jnedbal/stirrer_2_1/renders/stir06B_coils.png

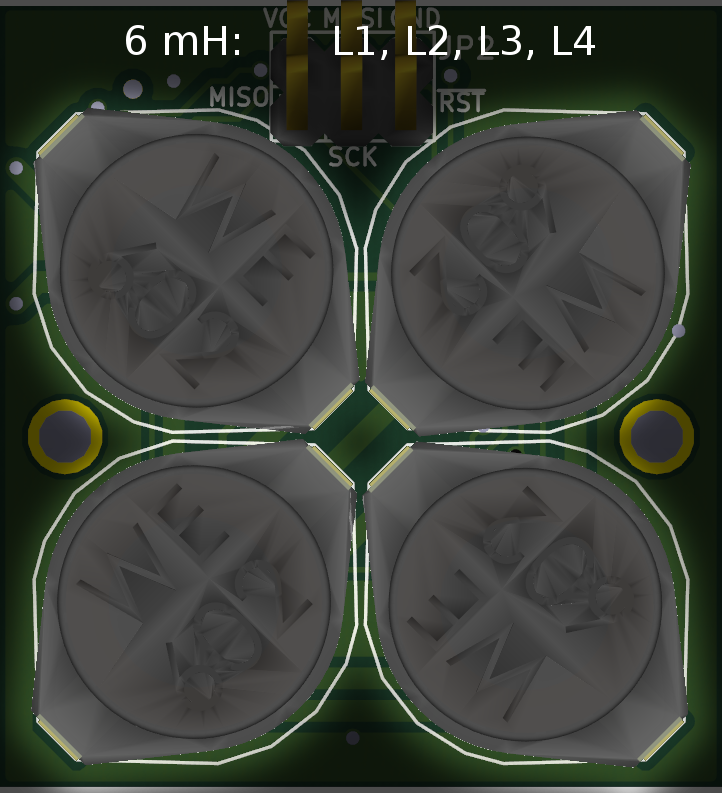
renders/stir06B_coils.png
