jnedbal/stirrer_2_1/renders/stir04F_analog.png

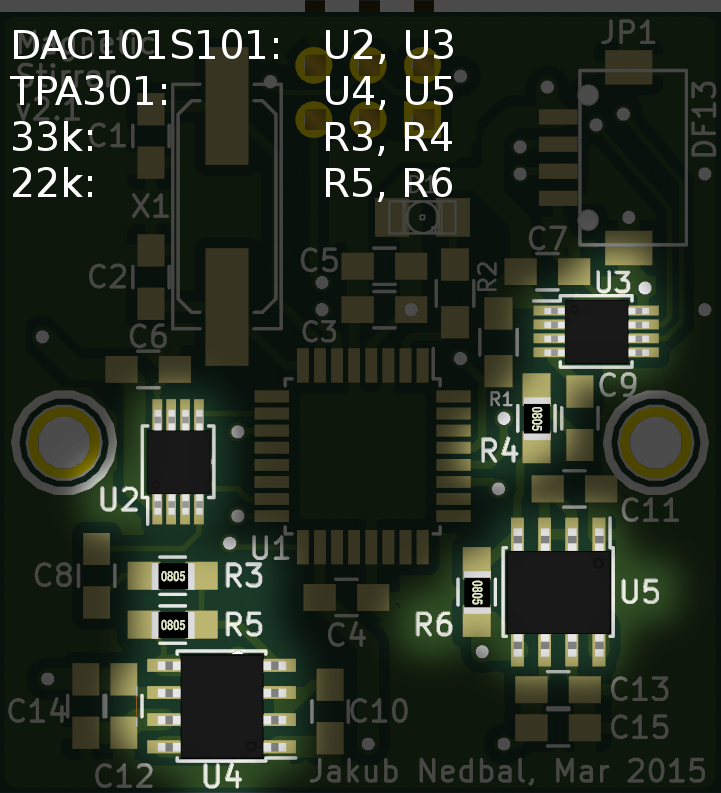
renders/stir04F_analog.png
