jnedbal/stirrer_2_1/connectors.png

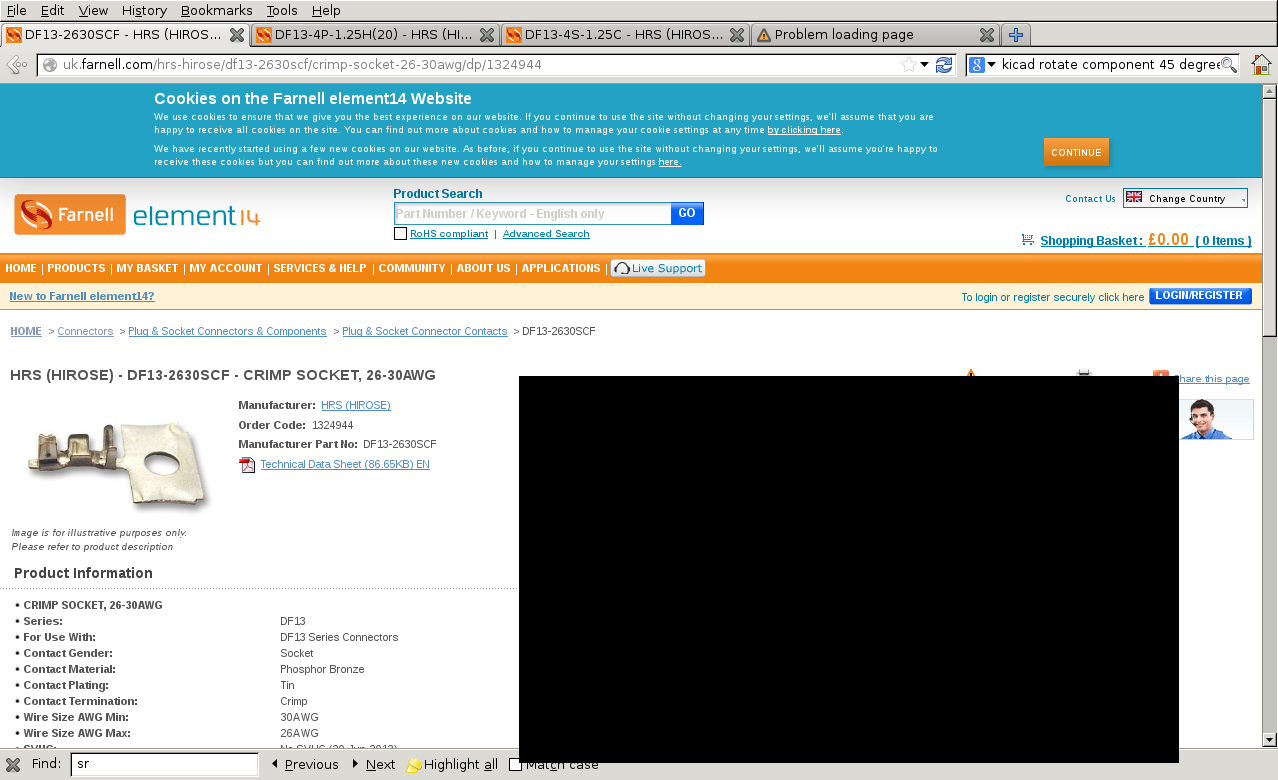
connectors.png
