jnedbal/stirrer_2_1/renders/3D/Animation.gif

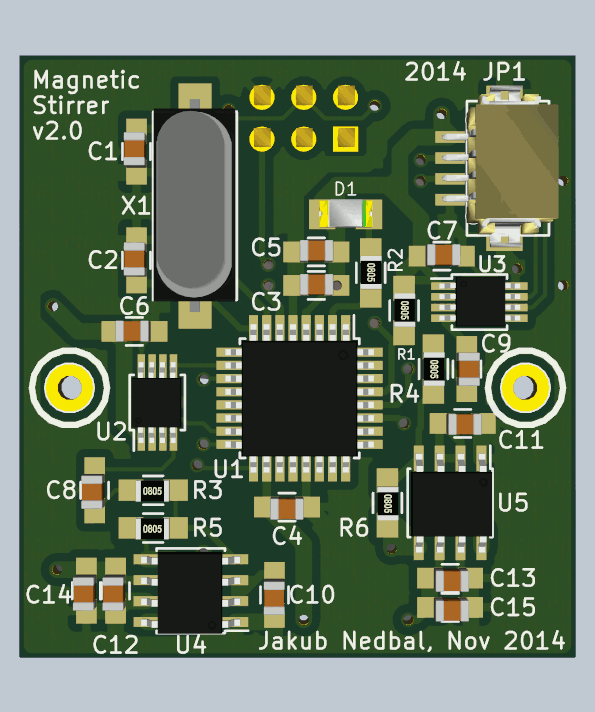
renders/3D/Animation.gif
