jnedbal/stirrer_2_1/renders/allB.png

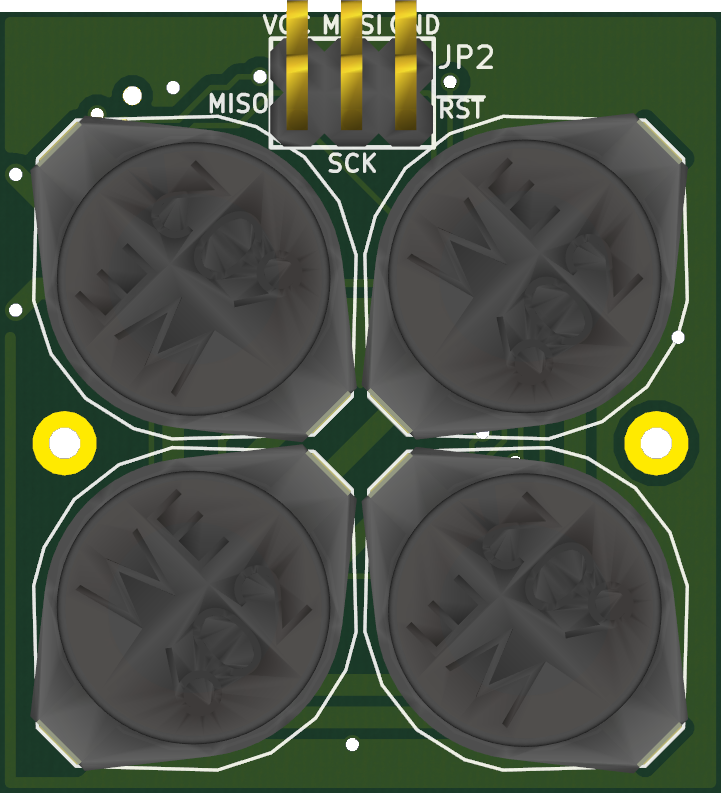
renders/allB.png
