jnedbal/stirrer_2_1/renders/allBempty.png

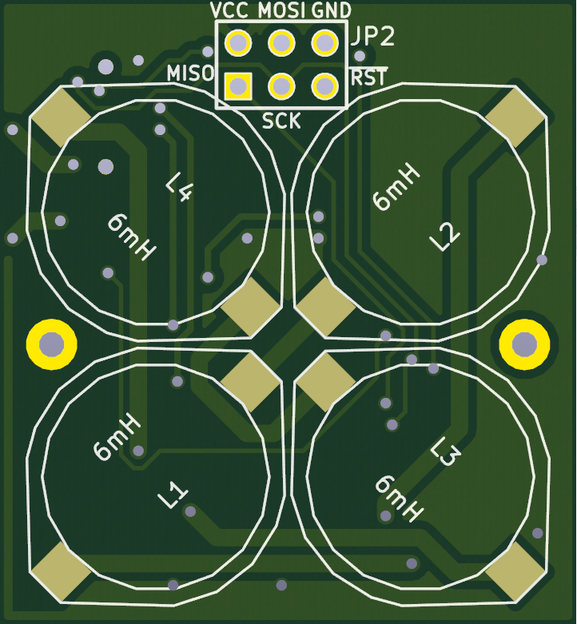
renders/allBempty.png
