jnedbal/stirrer_2_1/renders/allBparts.png

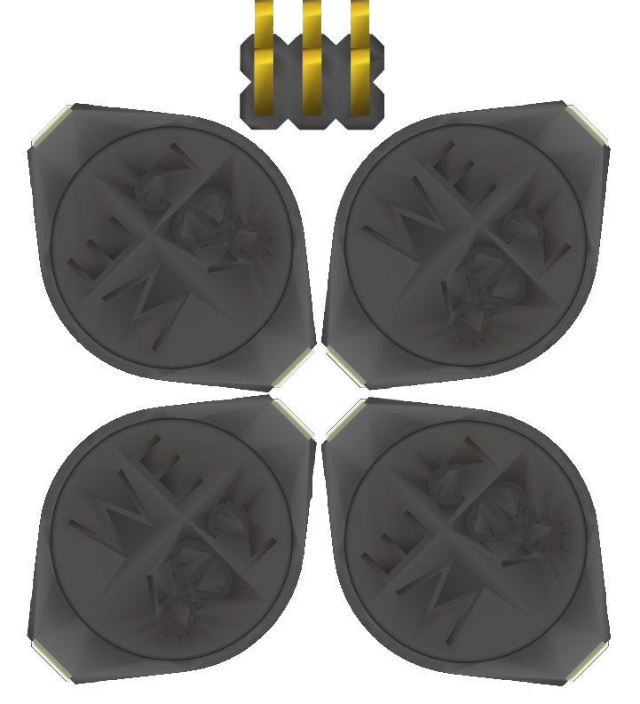
renders/allBparts.png
