jnedbal/stirrer_2_1/renders/allF.png

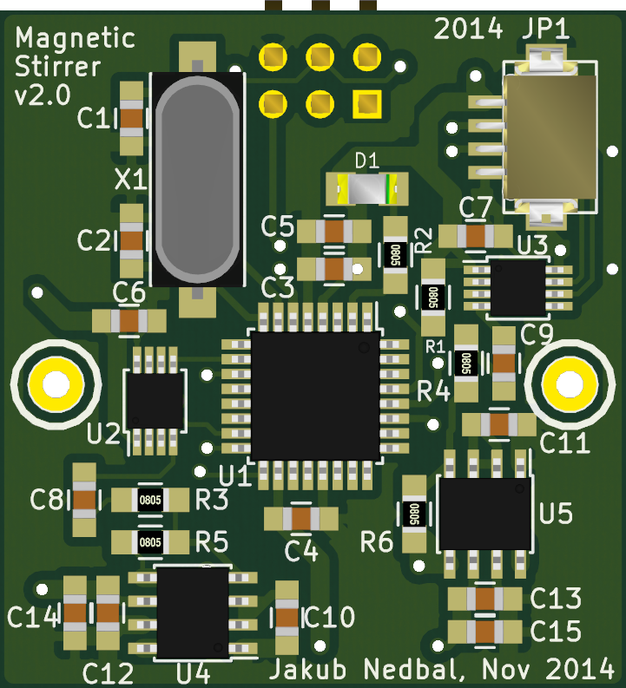
renders/allF.png
