jnedbal/stirrer_2_1/renders/allFempty.png

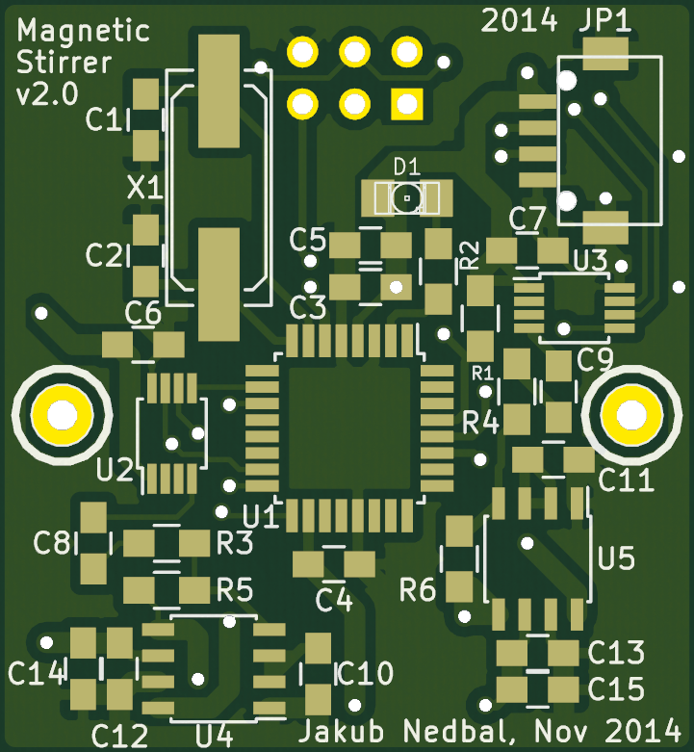
renders/allFempty.png
