jnedbal/stirrer_2_1/renders/allFparts.png

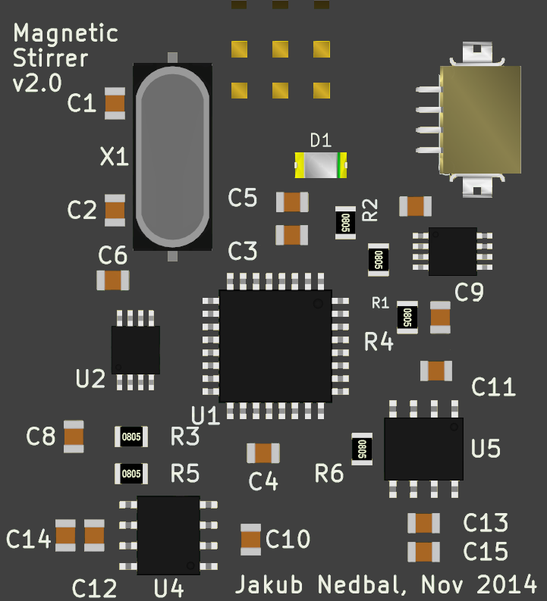
renders/allFparts.png
