jnedbal/stirrer_2_1/renders/stir00B_board.png

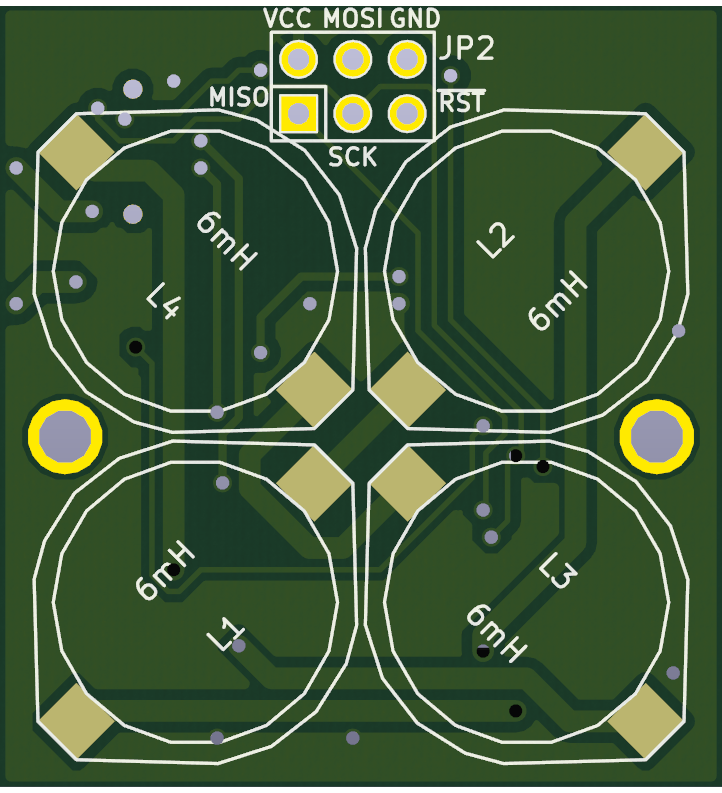
renders/stir00B_board.png
