jnedbal/stirrer_2_1/renders/stir01F_caps.png

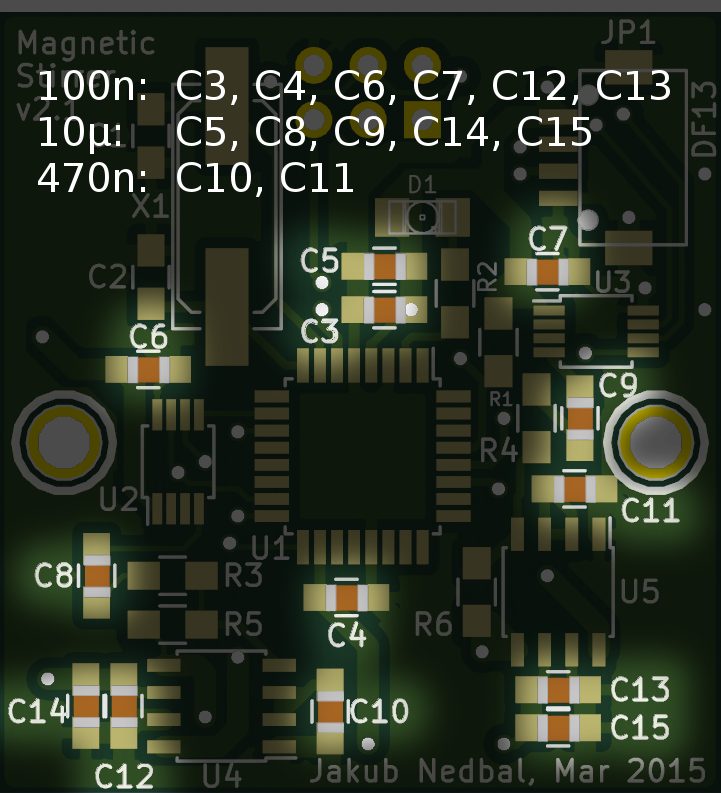
renders/stir01F_caps.png
