jnedbal/stirrer_2_1/renders/stir02F_cpu.png

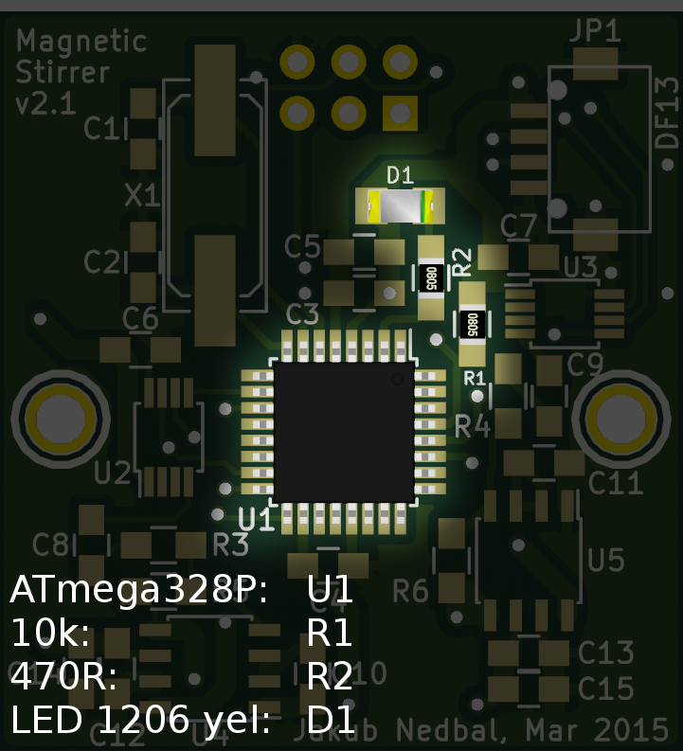
renders/stir02F_cpu.png
