jnedbal/stirrer_2_1/renders/stir03B_conn.png

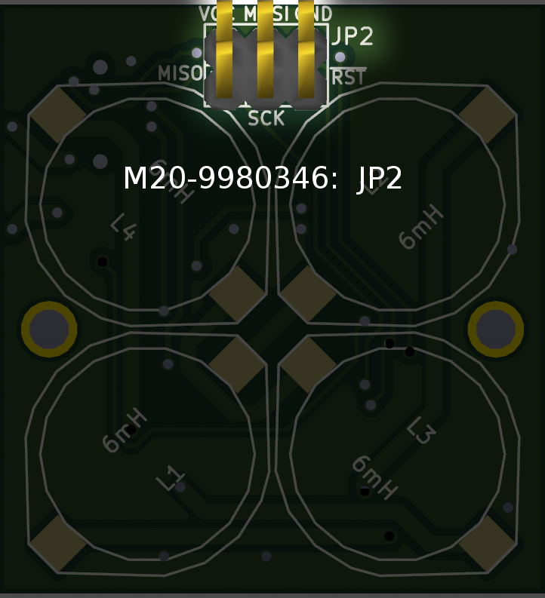
renders/stir03B_conn.png
