jnedbal/stirrer_2_1/renders/stir05F_conn.png

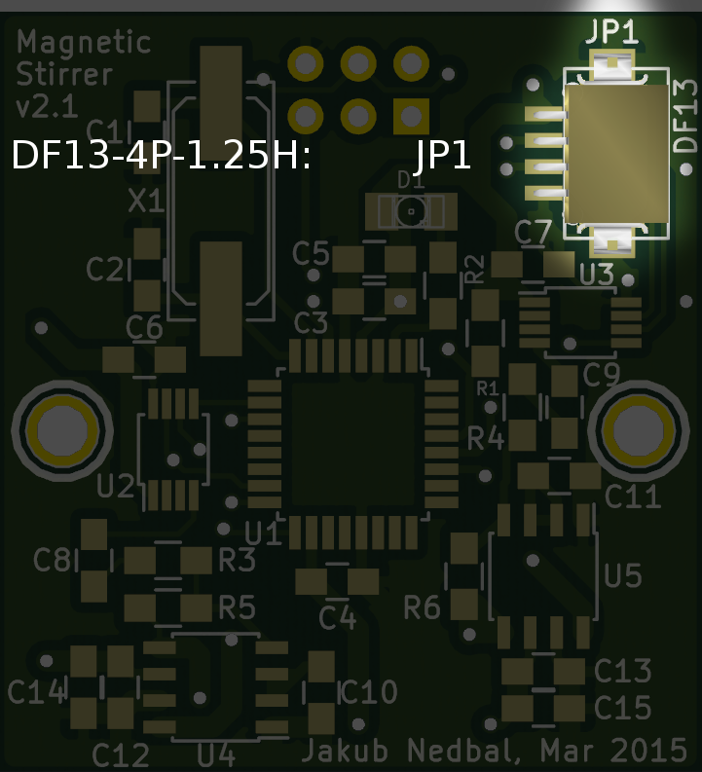
renders/stir05F_conn.png
