jnedbal/stirrer_2_1/renders/stir07F_xtal.png

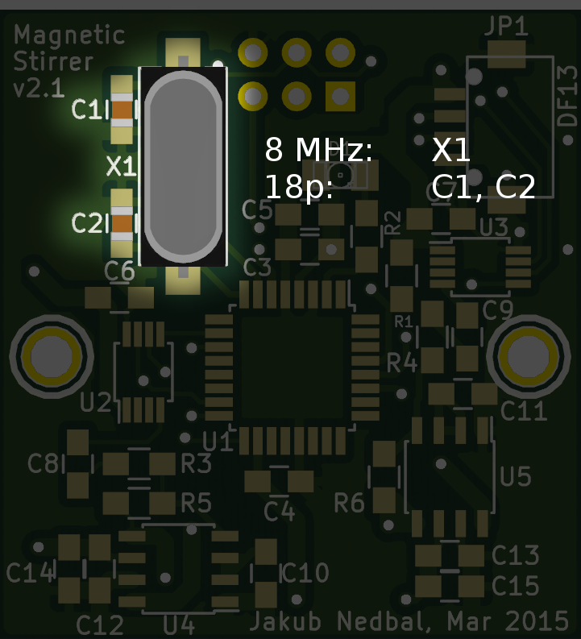
renders/stir07F_xtal.png
