jnedbal/stirrer_2_1/renders/stir08B_parts.png

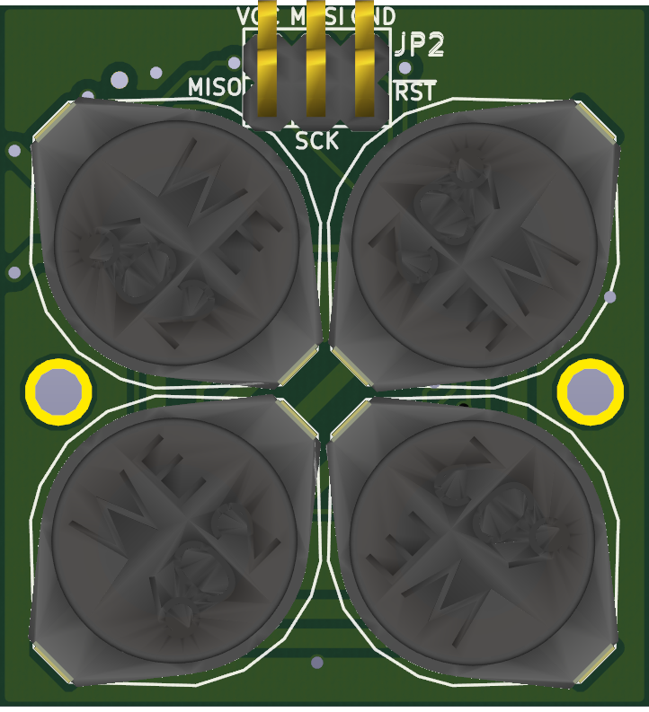
renders/stir08B_parts.png
