jnedbal/stirrer_2_1/stirrer_2_1.kicad_pcb

## KiCad design stirrer_2_1.kicad_pcb (2015-03-08)

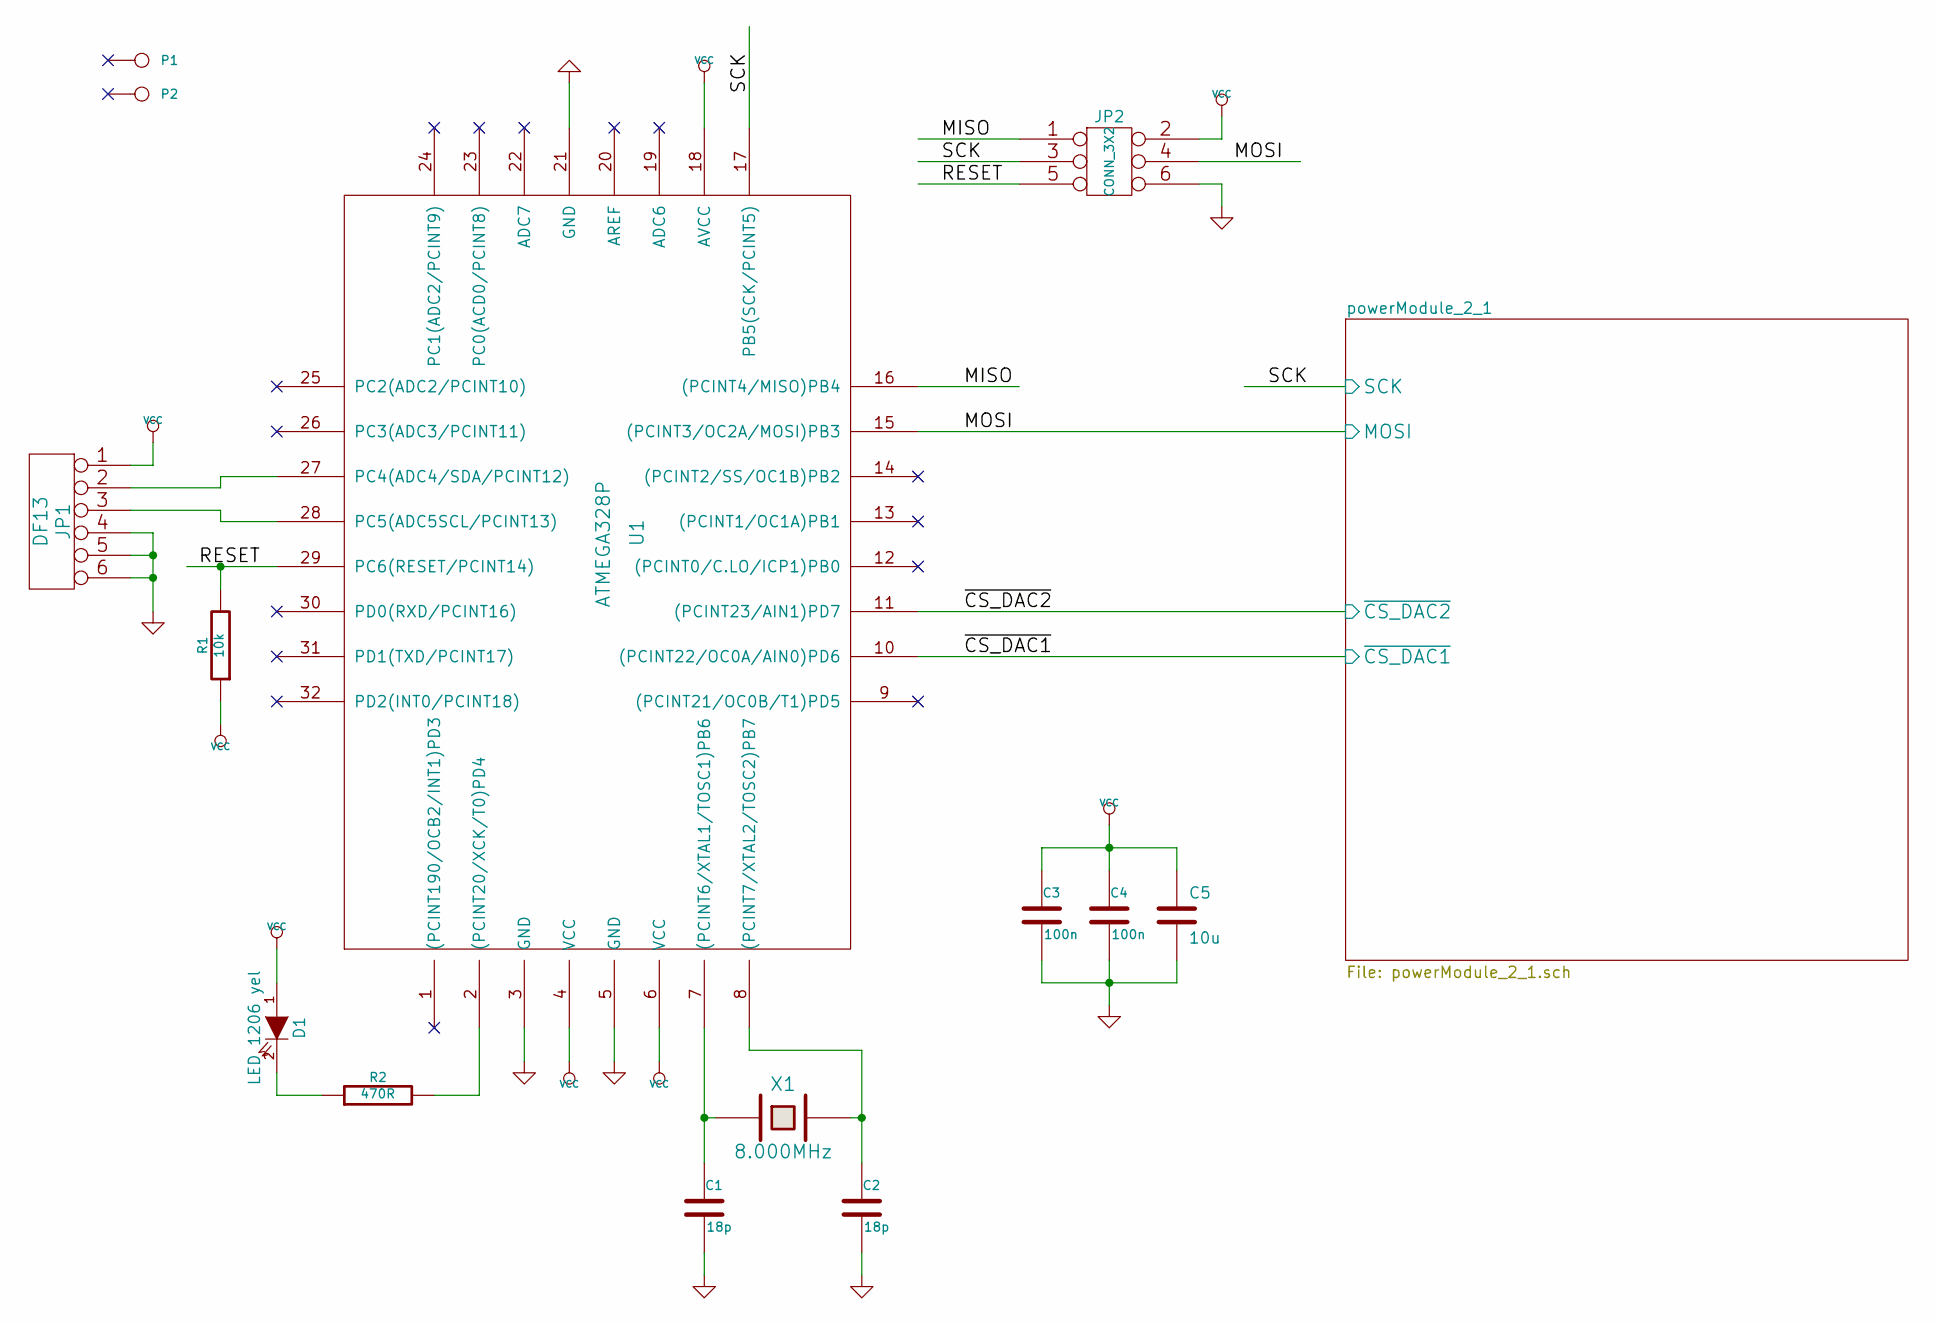
[picture p18: schematic stirrer_2_1.sch]

Parts:
C1, C2: 18p; C_0805_HandSoldering; Part Number MC0805N180J500CT
C3, C4: 100n; C_0805_HandSoldering; Part Number MCCA000274
C5: 10u; C_0805_HandSoldering; Part Number GRM219R61C106KA73D
D1: LED 1206 yel; LED-1206; Part Number LYN971-Z
JP1: DF13; DF13-4P-1.25H; Part Number DF13-4P-1.25H
JP2: CONN_3X2; Pin_Header_Straight_2x03; Part Number M20-9980346
P1, P2: CONN_1; 1pin
R1: 10k; R_0805_HandSoldering; Part Number MCMR08X1002FTL
R2: 470R; R_0805_HandSoldering; Part Number 109-9798
U1: ATMEGA328P; TQFP-32_7x7mm_Pitch0.8mm; Part Number ATMEGA328P-AU
X1: 8.000MHz; Q_49U3HMS; Part Number 9C-8.000MAAJ-T

Connections:
/MISO: JP2.1, U1.16 ((PCINT4/MISO)PB4)
/RESET: JP2.5, R1.2, U1.29 (PC6(RESET/PCINT14))
/powerModule_2_1/MOSI: JP2.4, U1.15 ((PCINT3/OC2A/MOSI)PB3); also elsewhere on the board
/powerModule_2_1/SCK: JP2.3, U1.17 (PB5(SCK/PCINT5)); also elsewhere on the board
/powerModule_2_1/~CS_DAC1: U1.10 ((PCINT22/OC0A/AIN0)PD6); also elsewhere on the board
/powerModule_2_1/~CS_DAC2: U1.11 ((PCINT23/AIN1)PD7); also elsewhere on the board
GND: C1.2, C2.2, C3.2, C4.2, C5.2, JP1.4, JP1.5, JP1.6, JP2.6, U1.3 (GND), U1.5 (GND), U1.21 (GND); also elsewhere on the board
unnamed: C1.1, U1.7 ((PCINT6/XTAL1/TOSC1)PB6), X1.1
unnamed: C2.1, U1.8 ((PCINT7/XTAL2/TOSC2)PB7), X1.2
unnamed: D1.2 (K), R2.1
unnamed: JP1.2, U1.27 (PC4(ADC4/SDA/PCINT12))
unnamed: JP1.3, U1.28 (PC5(ADC5SCL/PCINT13))
unnamed: R2.2, U1.2 ((PCINT20/XCK/T0)PD4)
VCC: C3.1, C4.1, C5.1, D1.1 (A), JP1.1, JP2.2, R1.1, U1.4 (VCC), U1.6 (VCC), U1.18 (AVCC); also elsewhere on the board

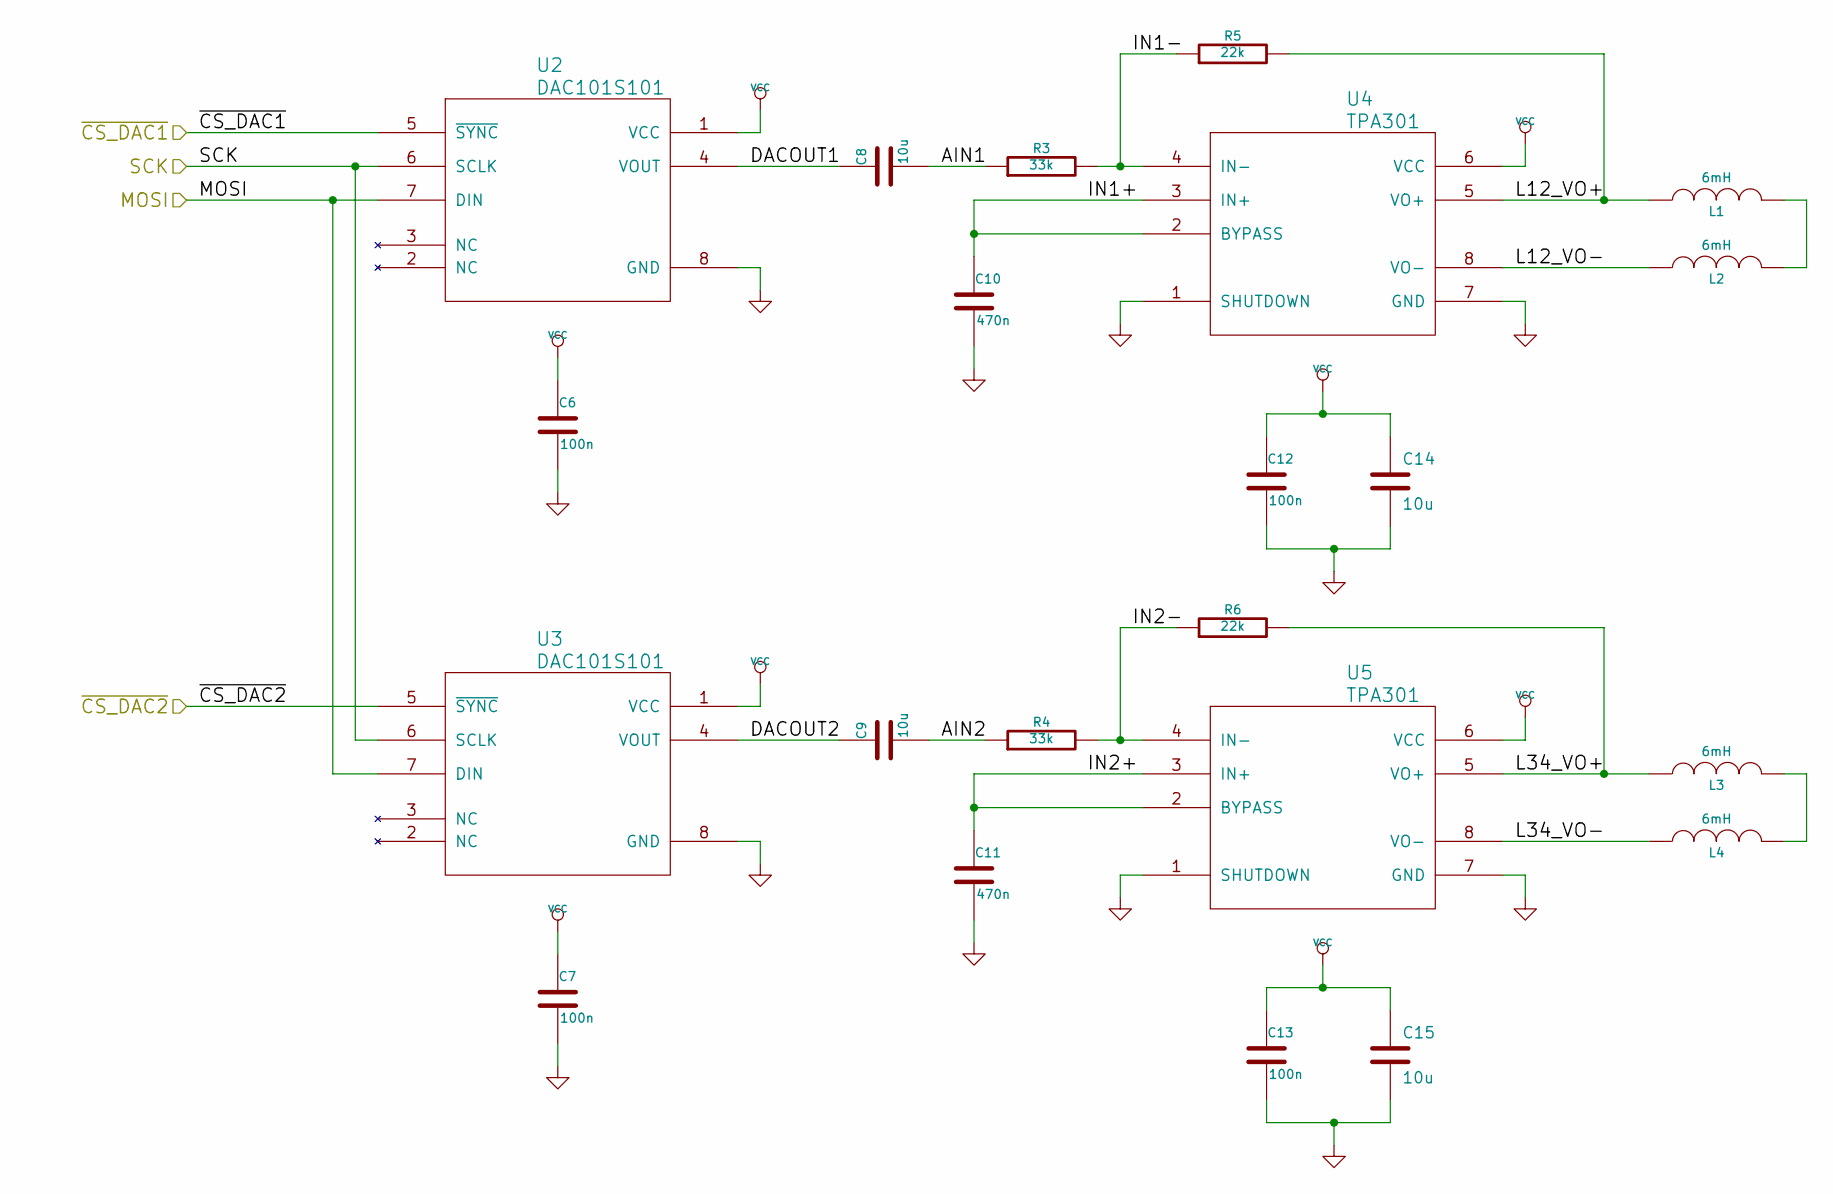
[picture p19: schematic powerModule_2_1.sch]

Parts:
C6, C7, C12, C13: 100n; C_0805_HandSoldering; Part Number MCCA000274
C8, C9, C14, C15: 10u; C_0805_HandSoldering; Part Number GRM219R61C106KA73D
C10, C11: 470n; C_0805_HandSoldering; Part Number MC0805B474K250CT
L1, L2, L3, L4: 6mH; 6mH_coil; Part Number 74458306
R3, R4: 33k; R_0805_HandSoldering; Part Number MC01W0805133K
R5, R6: 22k; R_0805_HandSoldering; Part Number MCMR08X2202FTL
U2, U3: DAC101S101; MSOP-8_3x3mm_Pitch0.65mm; Part Number DAC101S101CIMM
U4, U5: TPA301; SOIC-8_3.9x4.9mm_Pitch1.27mm; Part Number TPA301D

Connections:
/powerModule_2_1/AIN1: C8.2, R3.1
/powerModule_2_1/AIN2: C9.2, R4.1
/powerModule_2_1/DACOUT1: C8.1, U2.4 (VOUT)
/powerModule_2_1/DACOUT2: C9.1, U3.4 (VOUT)
/powerModule_2_1/IN1+: C10.1, U4.2 (BYPASS), U4.3 (IN+)
/powerModule_2_1/IN1-: R3.2, R5.1, U4.4 (IN-)
/powerModule_2_1/IN2+: C11.1, U5.2 (BYPASS), U5.3 (IN+)
/powerModule_2_1/IN2-: R4.2, R6.1, U5.4 (IN-)
/powerModule_2_1/L12_VO+: L1.1, R5.2, U4.5 (VO+)
/powerModule_2_1/L12_VO-: L2.1, U4.8 (VO-)
/powerModule_2_1/L34_VO+: L3.1, R6.2, U5.5 (VO+)
/powerModule_2_1/L34_VO-: L4.1, U5.8 (VO-)
/powerModule_2_1/MOSI: U2.7 (DIN), U3.7 (DIN); also elsewhere on the board
/powerModule_2_1/SCK: U2.6 (SCLK), U3.6 (SCLK); also elsewhere on the board
/powerModule_2_1/~CS_DAC1: U2.5 (~SYNC); also elsewhere on the board
/powerModule_2_1/~CS_DAC2: U3.5 (~SYNC); also elsewhere on the board
GND: C6.2, C7.2, C10.2, C11.2, C12.2, C13.2, C14.2, C15.2, U2.8 (GND), U3.8 (GND), U4.1 (SHUTDOWN), U4.7 (GND), U5.1 (SHUTDOWN), U5.7 (GND); also elsewhere on the board
unnamed: L1.2, L2.2
unnamed: L3.2, L4.2
VCC: C6.1, C7.1, C12.1, C13.1, C14.1, C15.1, U2.1 (VCC), U3.1 (VCC), U4.6 (VCC), U5.6 (VCC); also elsewhere on the board

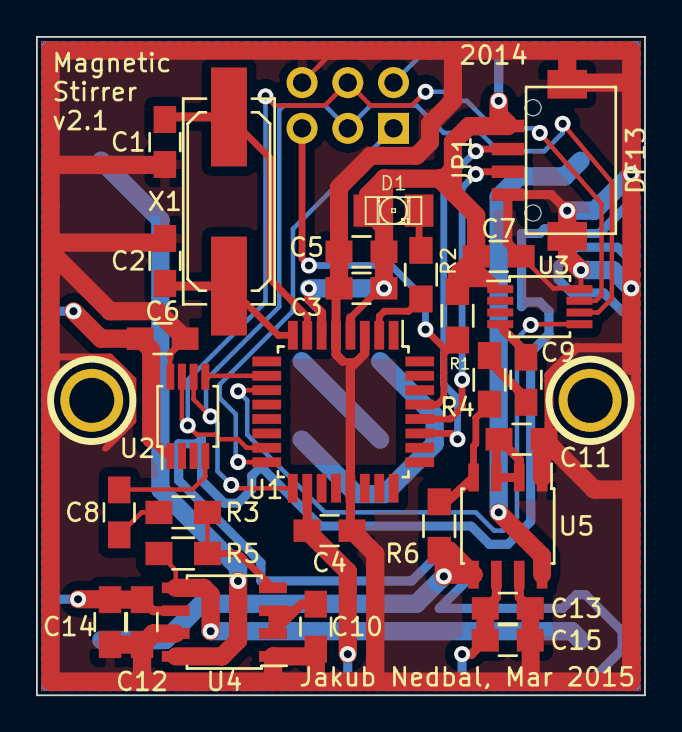
[picture p20: board stirrer_2_1.kicad_pcb from above]

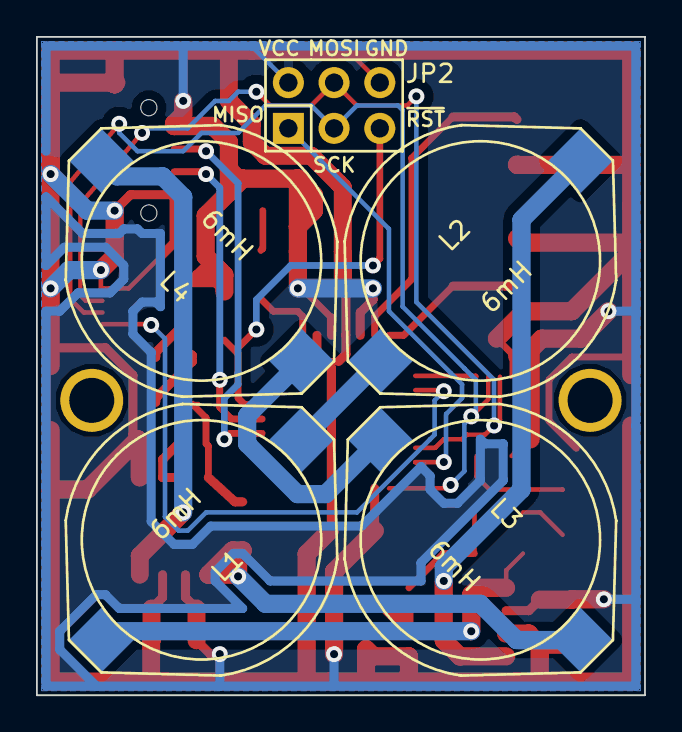
[picture p21: board stirrer_2_1.kicad_pcb from below]

Board: 2 copper layers, 33.8 x 36.6 mm, 36 parts (5 on the bottom side), 28 nets.
